wheeler-microfluidics/kicad___signal_generator_board/docs/src/Signal generator board (front).jpg

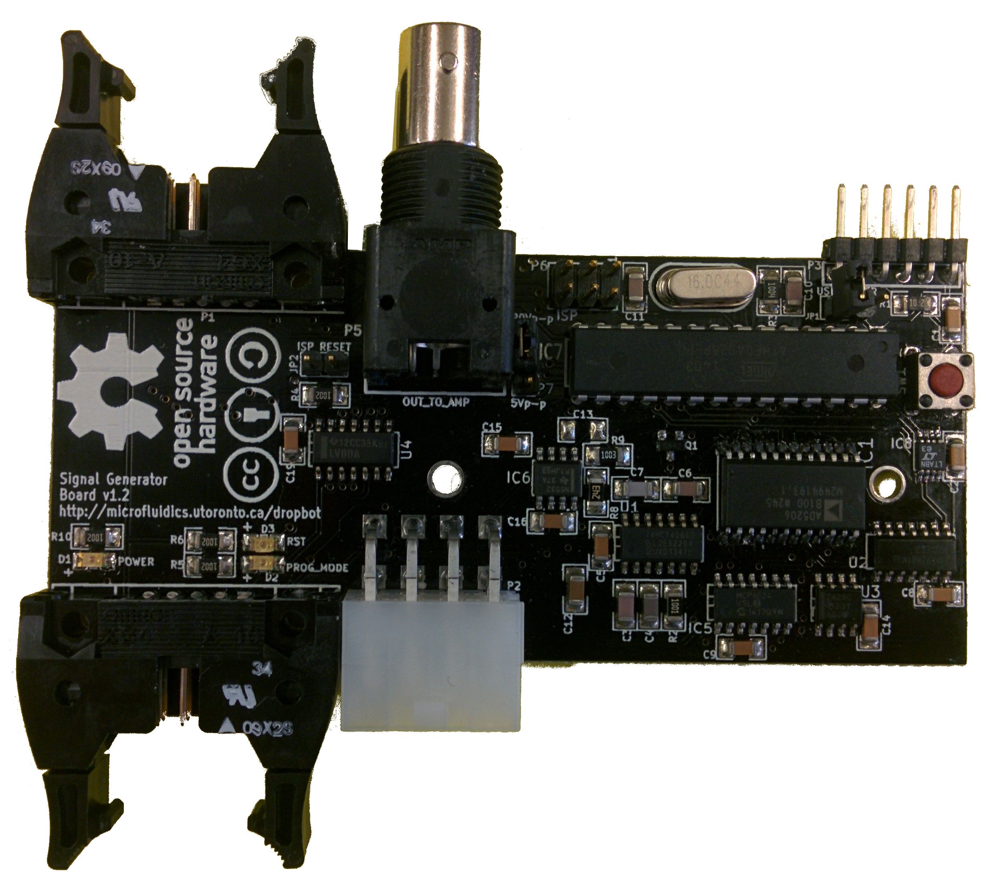
docs/src/Signal generator board (front).jpg
