wheeler-microfluidics/kicad___signal_generator_board/docs/Signal generator board v1.2 documentation.odt

Signal generator board v1.2

http://microfluidics.utoronto.ca/trac/dropbot/wiki/SignalGeneratorBoard

Document revision: 2

Last updated: 2015-03-12

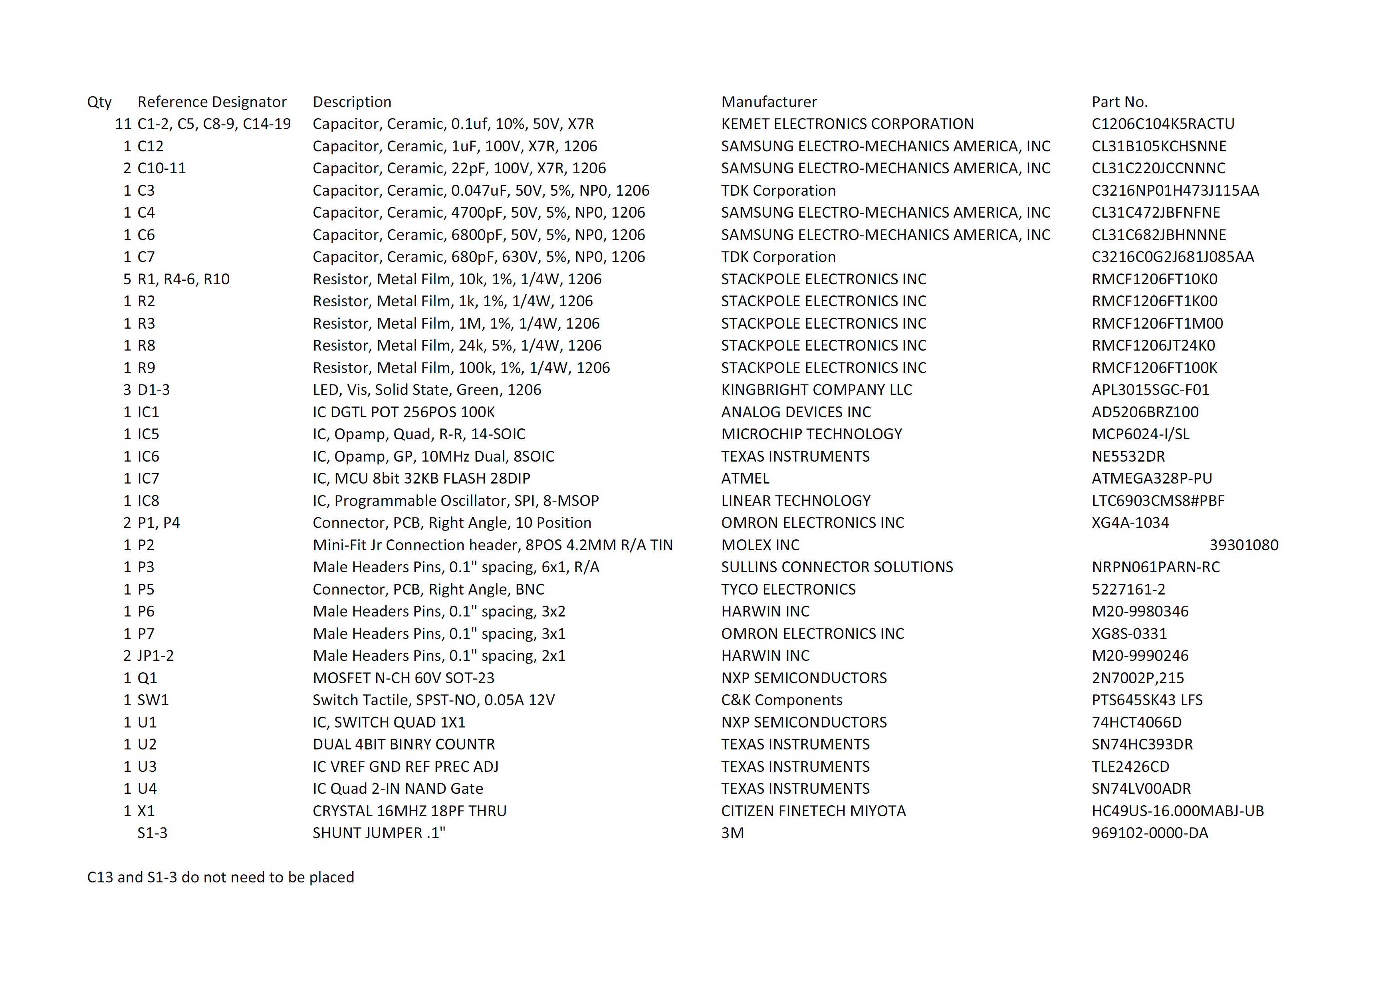
[picture p2: figure]
