wheeler-microfluidics/kicad___signal_generator_board/docs/png/Signal generator board layout (front).png

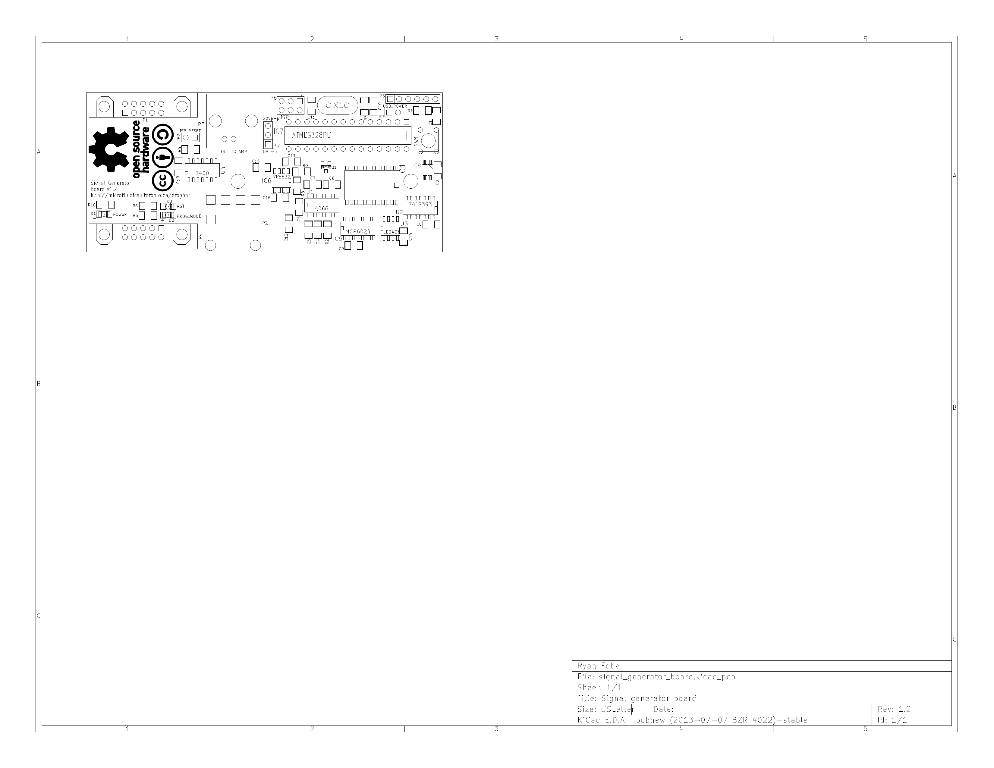
docs/png/Signal generator board layout (front).png
