wheeler-microfluidics/kicad___signal_generator_board/docs/png/Signal generator board schematic.png

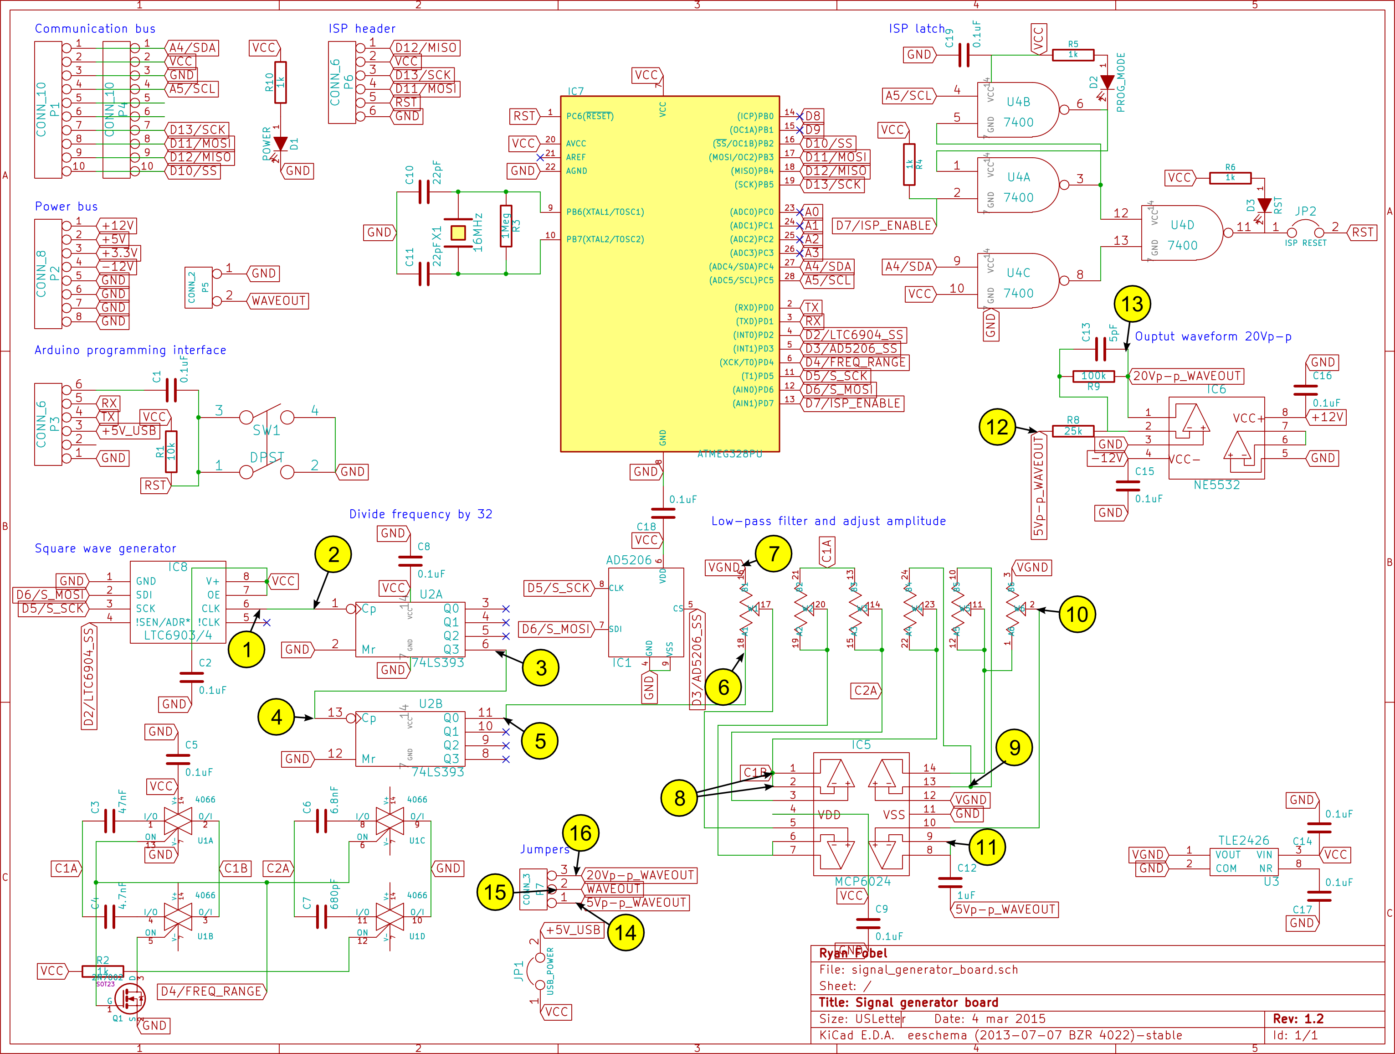
docs/png/Signal generator board schematic.png
