wheeler-microfluidics/kicad___signal_generator_board/docs/src/Signal generator board layout (back).pdf

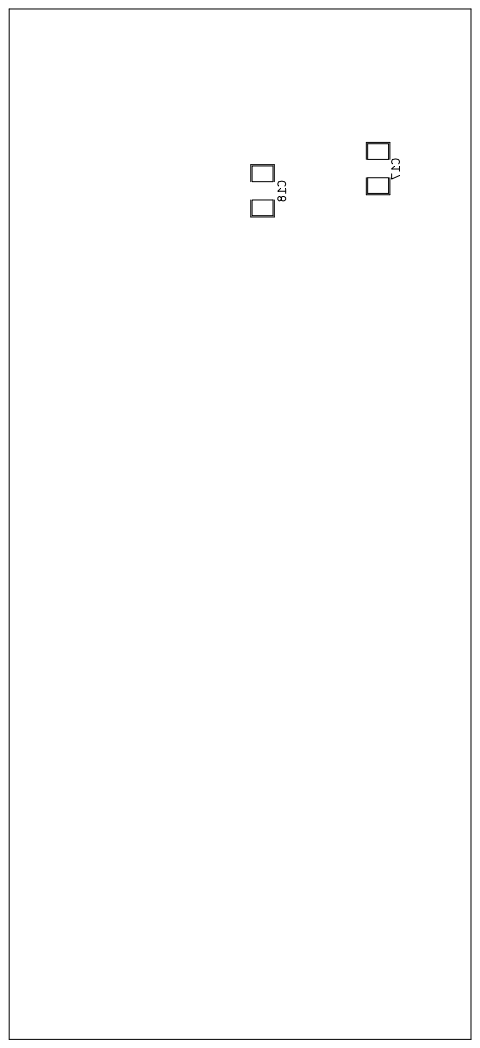
[picture p6: page 1]
