wheeler-microfluidics/kicad___signal_generator_board/docs/src/Signal generator board layout (front).pdf

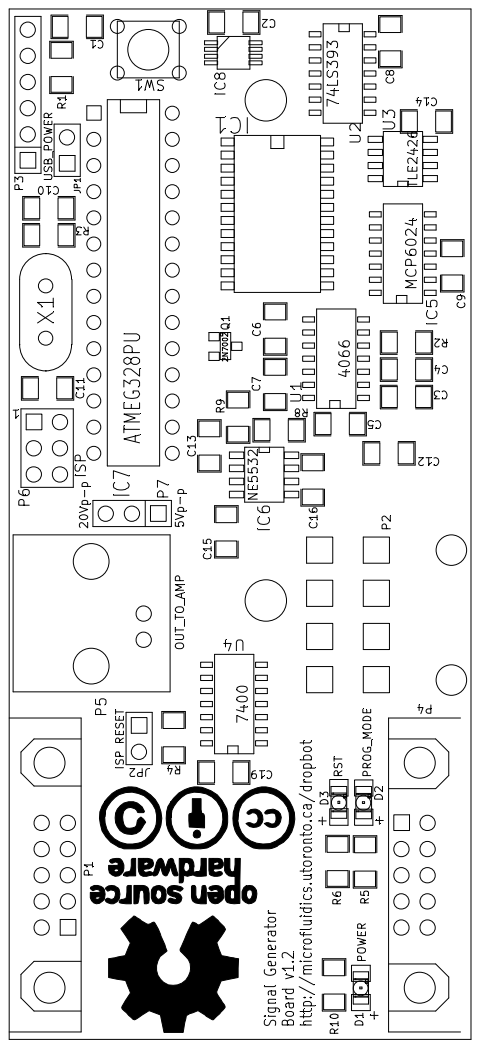
[picture p7: page 1]
