wheeler-microfluidics/kicad___signal_generator_board/signal_generator_board.kicad_pcb

## KiCad design signal_generator_board.kicad_pcb (2014-05-28)

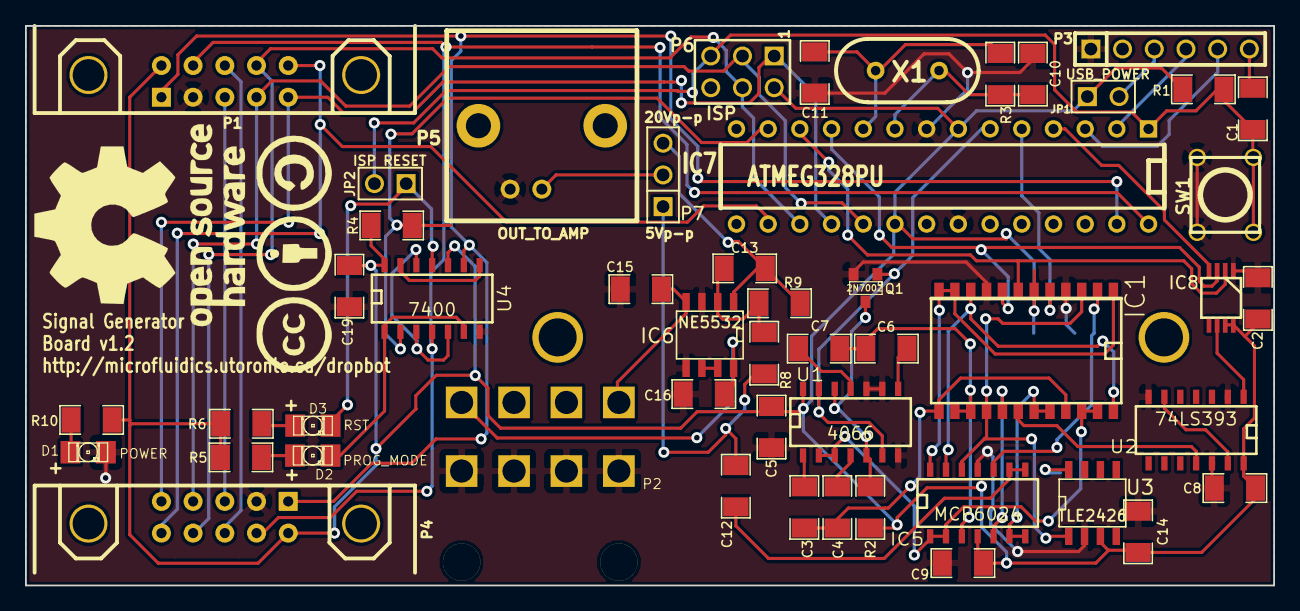
[picture p8: board signal_generator_board.kicad_pcb from above]

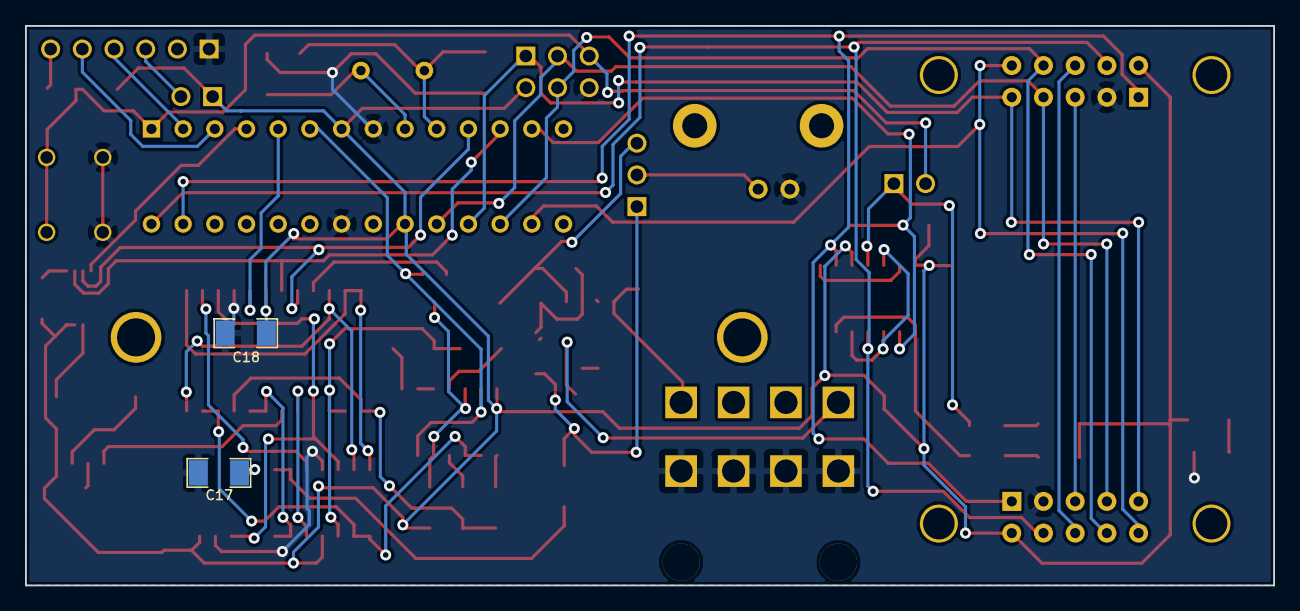
[picture p9: board signal_generator_board.kicad_pcb from below]

Board: 2 copper layers, 100.0 x 44.8 mm, 54 parts (2 on the bottom side), 56 nets.

Parts:
1PIN, 1PIN#2: P***; 1pin
C1, C2, C5, C8, C9, C14, C15, C16, C17, C18, C19: 0.1uF; SM1206
C3: 47nF; SM1206
C4: 4.7nF; SM1206
C6: 6.8nF; SM1206
C7: 680pF; SM1206
C10, C11: 22pF; SM1206
C12: 1uF; SM1206
C13: 5pF; SM1206
D1: POWER; LED-1206
D2: PROG_MODE; LED-1206
D3: RST; LED-1206
IC1: AD5206; SO24E
IC5: MCP6024; SO14E
IC6: NE5532; SO8E
IC7: ATMEG328PU; DIP-28
IC8: LTC6903/4; MSOP_8
JP1: USB_POWER; PIN_ARRAY_2X1
JP2: ISP RESET; PIN_ARRAY_2X1
P1, P4: CONN_10; HE10-10C
P2: CONN_8; Molex_4x2_Mini_Fit_Jr_RA
P3: CONN_6; PIN_ARRAY-6X1
P5: CONN_2; JACK_BNC
P6: CONN_6; pin_array_3x2
P7: CONN_3; PIN_ARRAY_3X1
Q1: 2N7002; SOT23
R1: 10k; SM1206
R2, R4, R5, R6, R10: 1k; SM1206
R3: 1Meg; SM1206
R8: 25k; SM1206
R9: 100k; SM1206
SW1: DPST; SW_PUSH_6mm
U1: 4066; SO14E
U2: 74LS393; SO14E
U3: TLE2426; SO8E
U4: 7400; SO14E
X1: 16MHz; HC-49V

Connections:
5Vp-p_WAVEOUT: C12.2, P7.1, R8.1
20Vp-p_WAVEOUT: C13.2, IC6.1, P7.3, R9.1
+5V_USB: JP1.2, P3.3
+12V: C16.2, IC6.8, P2.1
-12V: C15.1, IC6.4, P2.4
A4/SDA: IC7.27, P1.1, P4.1, U4.9
A5/SCL: IC7.28, P1.4, P4.4, U4.4
C1A: C3.1, C4.1, IC1.13, IC1.21
C1B: IC1.22, IC1.23, IC5.1, IC5.2, U1.2, U1.3
C2A: C6.1, C7.1, IC1.14, IC1.15, IC5.3
D2/LTC6904_SS: IC7.4, IC8.4
D3/AD5206_SS: IC1.5, IC7.5
D4/FREQ_RANGE: IC7.6, Q1.1, U1.6, U1.13
D5/S_SCK: IC1.8, IC7.11, IC8.3
D6/S_MOSI: IC1.7, IC7.12, IC8.2
D7/ISP_ENABLE: IC7.13, R4.2, U4.2
D10/SS: IC7.16, P1.10, P4.10
D11/MOSI: IC7.17, P1.8, P4.8, P6.4
D12/MISO: IC7.18, P1.9, P4.9, P6.1
D13/SCK: IC7.19, P1.7, P4.7, P6.3
GND: C2.2, C5.1, C8.1, C9.2, C10.1, C11.1, C14.2, C15.2, C16.1, C17.1, C18.2, C19.1, D1.2, IC1.4, IC1.9, IC5.11, IC6.3, IC6.5, IC7.8, IC7.22, IC8.1, P1.3, P2.5, P2.6, P2.7, P2.8, P3.1, P4.3, P5.1, P6.6, Q1.2, SW1.2, SW1.4, U1.7, U1.9, U1.10, U2.2, U2.7, U2.12, U3.2, U4.7
unnamed: IC8.6, U2.1
unnamed: IC6.6, IC6.7
unnamed: U2.6, U2.13
unnamed: IC1.18, U2.11
unnamed: IC1.17, IC5.5
unnamed: IC1.2, IC5.10
unnamed: C12.1, IC5.8, IC5.9
unnamed: IC1.10, IC1.24, IC5.13
unnamed: Q1.3, R2.2, U1.5, U1.12
unnamed: C3.2, U1.1
unnamed: C4.2, U1.4
unnamed: C6.2, U1.8
unnamed: C7.2, U1.11
unnamed: P1.6, P4.6
unnamed: C1.1, P3.6
unnamed: P1.5, P4.5
unnamed: U4.8, U4.13
unnamed: D3.1, R6.2
unnamed: D3.2, JP2.1, U4.11
unnamed: D2.1, R5.2
unnamed: D2.2, U4.1, U4.6
unnamed: IC1.1, IC1.11, IC1.12, IC5.14
unnamed: IC1.19, IC1.20, IC5.6, IC5.7
unnamed: C17.2, U3.8
unnamed: U4.3, U4.5, U4.12
unnamed: C13.1, IC6.2, R8.2, R9.2
unnamed: D1.1, R10.1
unnamed: C11.2, IC7.10, R3.2, X1.1
unnamed: C10.2, IC7.9, R3.1, X1.2
RST: C1.2, IC7.1, JP2.2, P6.5, R1.1, SW1.1, SW1.3
RX: IC7.3, P3.5
TX: IC7.2, P3.4
VCC: C2.1, C5.2, C8.2, C9.1, C14.1, C18.1, C19.2, IC1.6, IC5.4, IC7.7, IC7.20, IC8.7, IC8.8, JP1.1, P1.2, P4.2, P6.2, R1.2, R2.1, R4.1, R5.1, R6.1, R10.2, U1.14, U2.14, U3.3, U4.10, U4.14
VGND: IC1.3, IC1.16, IC5.12, U3.1
WAVEOUT: P5.2, P7.2
