wheeler-microfluidics/kicad___signal_generator_board/(commit log)

2013-08-29 Add missing parts to BOM
    [signal_generator_board-BOM.xls, signal_generator_board.kicad_pcb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]
2013-09-03 Fix link on BOM
    [signal_generator_board-BOM.xls, signal_generator_board.kicad_pcb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]
2013-09-11 Add paste and pos files
    [signal_generator_board.kicad_pcb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]
2013-09-19 Make drill file compatible with gerbmerge
    [signal_generator_board.drl]
2013-10-09 Swap ATmega328 for ATmega328P on BOM
    Makes it easier to flash Arduino bootloader
    [signal_generator_board-BOM.xls]
2013-10-09 Add note to BOM about optional cap (C13)
    [signal_generator_board-BOM.xls]
2013-10-09 Add shunts to BOM
    [signal_generator_board-BOM.xls]
2013-10-24 Change C4 and C7 (update BOM)
    [signal_generator_board-BOM.xls, signal_generator_board.kicad_pcb, signal_generator_board.sch]
2013-12-18 Fix #37
    Remove DC bias from 5 Vpk-pk output
    [signal_generator_board-B_Cu.gbl, signal_generator_board-B_Mask.gbs, signal_generator_board-B_Paste.gbp, signal_generator_board-B_SilkS.gbo, signal_generator_board-Edge_Cuts.gbr, signal_generator_board-F_Cu.gtl, signal_generator_board-F_Mask.gts, signal_generator_board-F_Paste.gtp]
2014-05-08 Add ISP prgramming, replace 0603 caps with 1206, ...
    * add polarity labels to LEDs
    [signal_generator_board-BOM.xls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]
2014-05-28 Fix BOM, labels, modify to use soft/bitbanged SPI
    [signal_generator_board-BOM.csv, signal_generator_board-BOM.xls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]
2014-07-24 Fix part number on BOM for P3
    [signal_generator_board-BOM.csv]
2015-02-17 Fix part number for P3 on BOM
    [signal_generator_board-BOM.csv]
2015-02-24 Add BNC nut and lock washer to BOM
    [signal_generator_board-BOM.csv]
2015-03-12 Fix frequency divisor on schematic (32, not 16)
    [signal_generator_board.sch]
